JamesByers/esp8266_alexa_led_control_with_manual_adjustments/assets/bi_directional_level_shifter_circuit_diagram.jpg

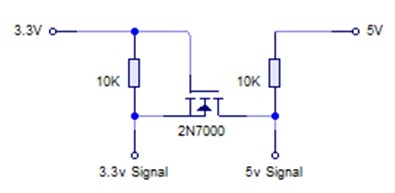
assets/bi_directional_level_shifter_circuit_diagram.jpg
