JamesByers/esp8266_alexa_led_control_with_manual_adjustments/assets/first_board.jpg

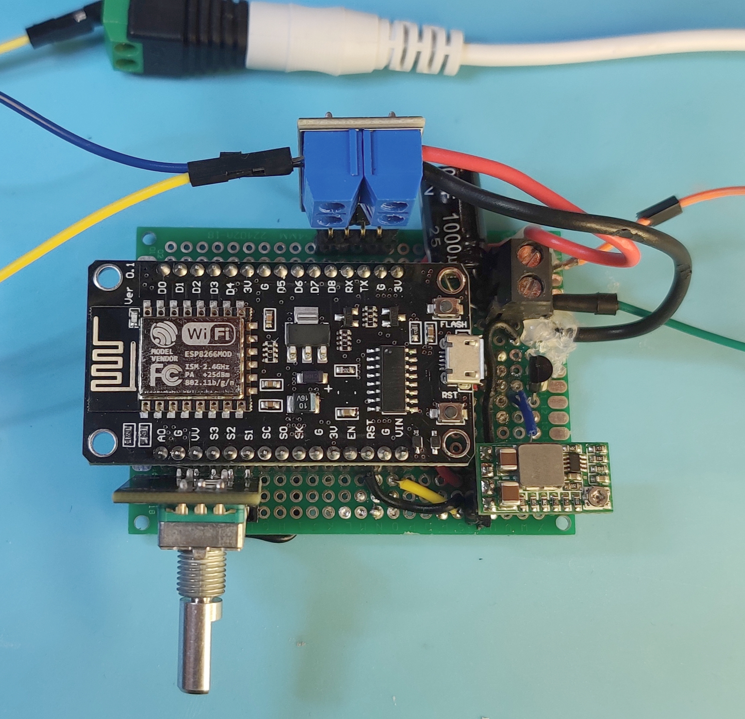
assets/first_board.jpg
