JamesByers/esp8266_alexa_led_control_with_manual_adjustments/assets/Mosfet_level_shift_driver_for_power_mosfet_module.png

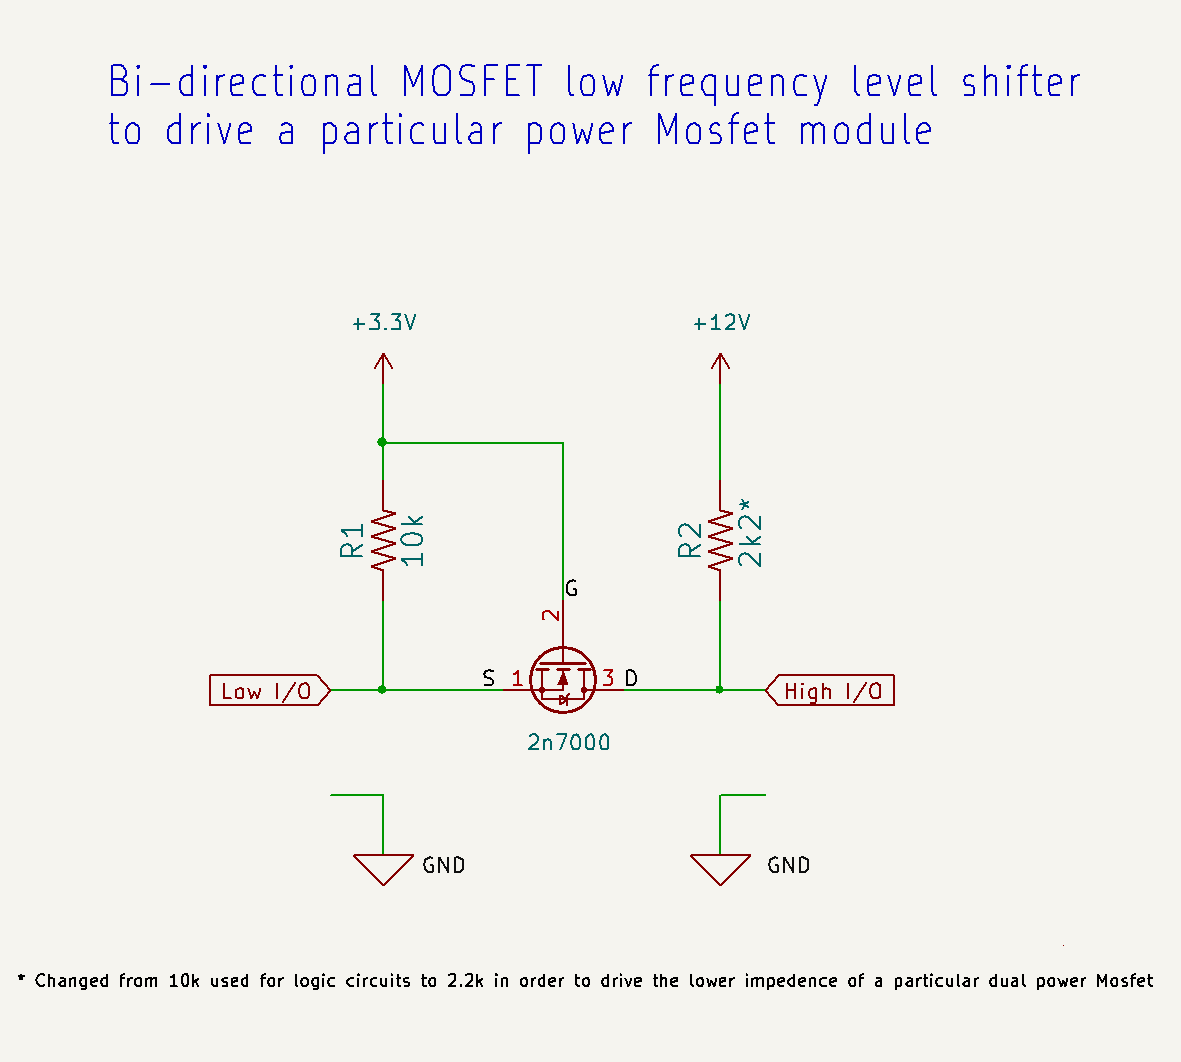
assets/Mosfet_level_shift_driver_for_power_mosfet_module.png
