JamesByers/esp8266_alexa_led_control_with_manual_adjustments/assets/mosfet_level_shifter_12v.png

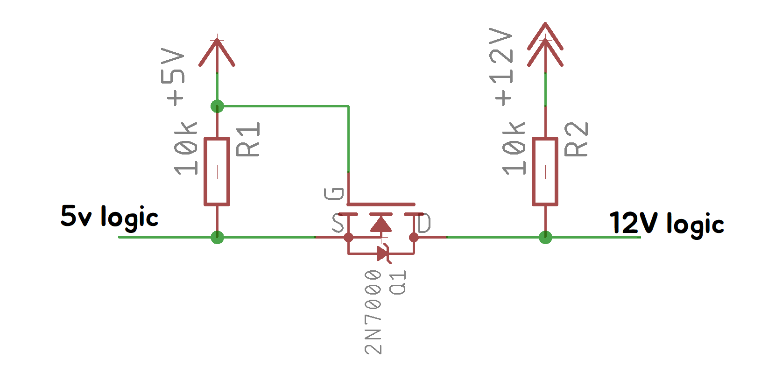
assets/mosfet_level_shifter_12v.png
