JamesByers/esp8266_alexa_led_control_with_manual_adjustments/assets/scope_images/best/dimmer_driver_1per_pulses.png

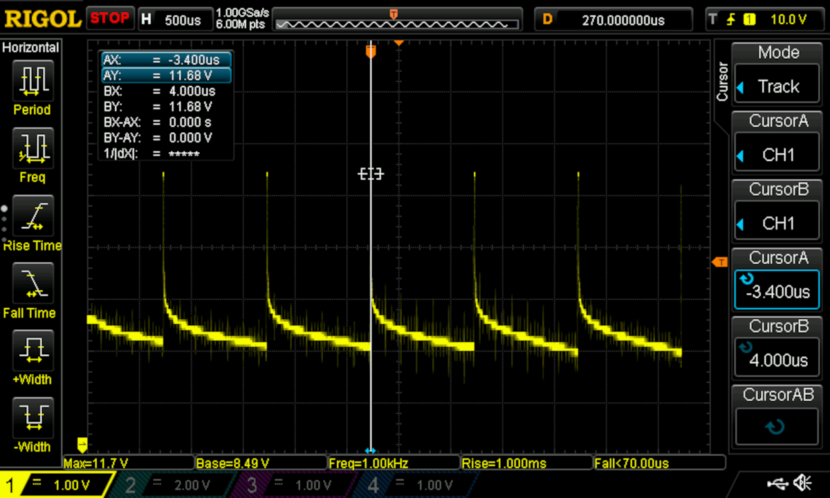
assets/scope_images/best/dimmer_driver_1per_pulses.png
