JamesByers/esp8266_alexa_led_control_with_manual_adjustments/assets/scope_images/best/dimmer_driver_60hz_wave_when_LED_off.png

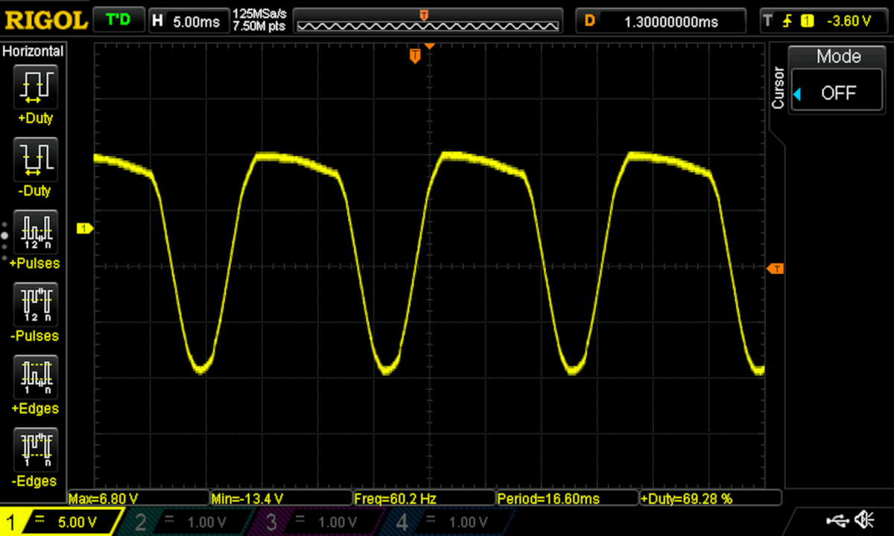
assets/scope_images/best/dimmer_driver_60hz_wave_when_LED_off.png
