JamesByers/esp8266_alexa_led_control_with_manual_adjustments/assets/scope_images/best/LED_strip_PWM_with_1uf_rise_and_ring1.png

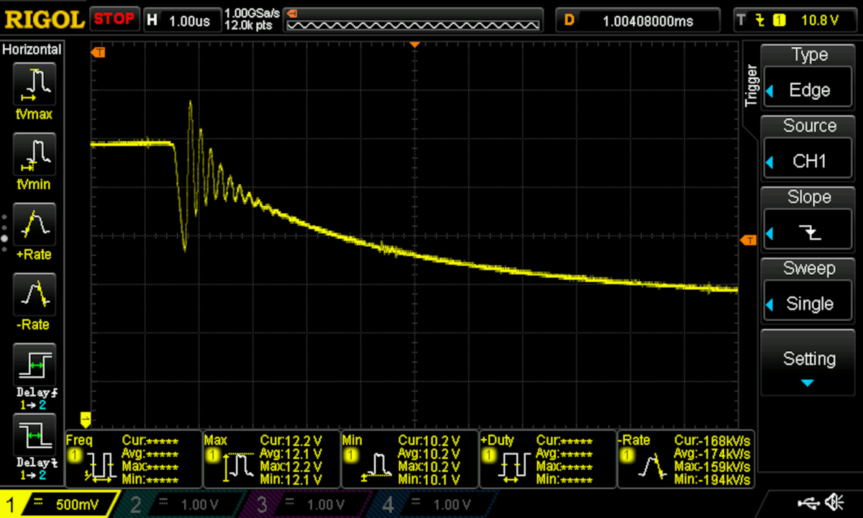
assets/scope_images/best/LED_strip_PWM_with_1uf_rise_and_ring1.png
