JamesByers/esp8266_alexa_led_control_with_manual_adjustments/assets/small_signal_transistor_with_v_gain_inverting.gif

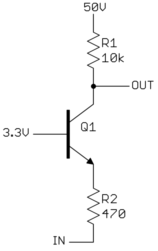
assets/small_signal_transistor_with_v_gain_inverting.gif
