JamesByers/esp8266_alexa_led_control_with_manual_adjustments/assets/very_small_buck_converter_back.jpg

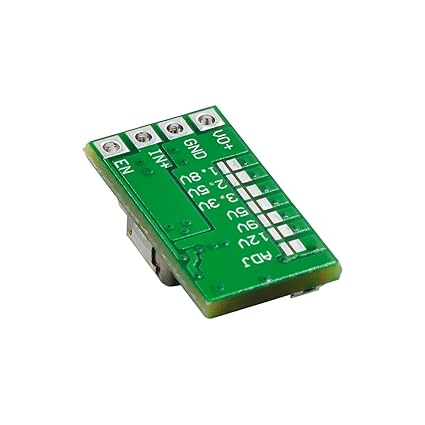
assets/very_small_buck_converter_back.jpg
