JamesByers/esp8266_alexa_led_control_with_manual_adjustments/assets/scope_images/best/LED_strip_PWM_result.png

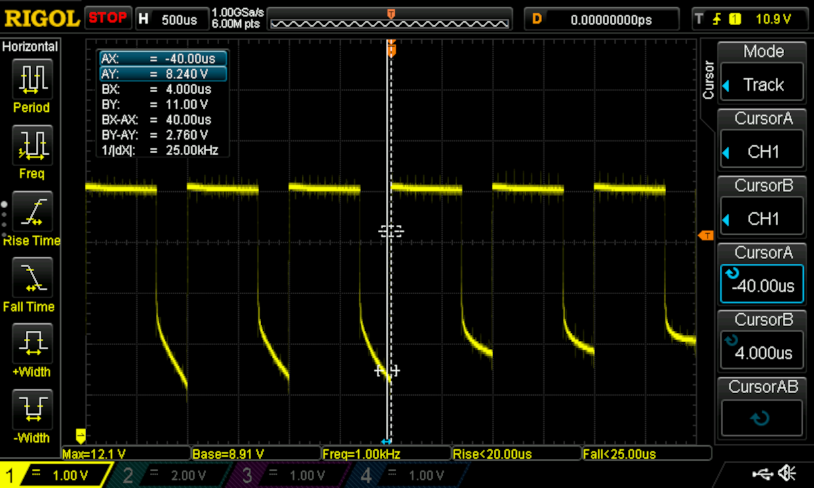
assets/scope_images/best/LED_strip_PWM_result.png
